sqfmi/beepy-hardware/3D/beepy-cases/slim_flat/README.md

# Slim, flat, minimal case for the Beepy
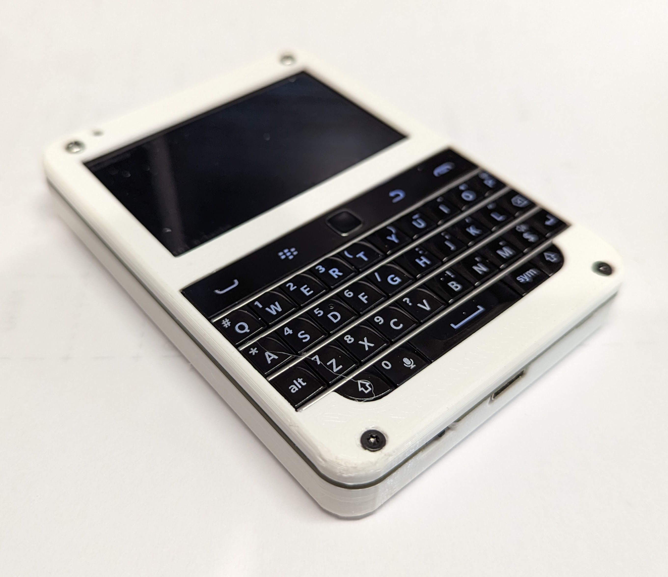
[picture p4: 3D/beepy-cases/slim_flat/images/01.jpg]
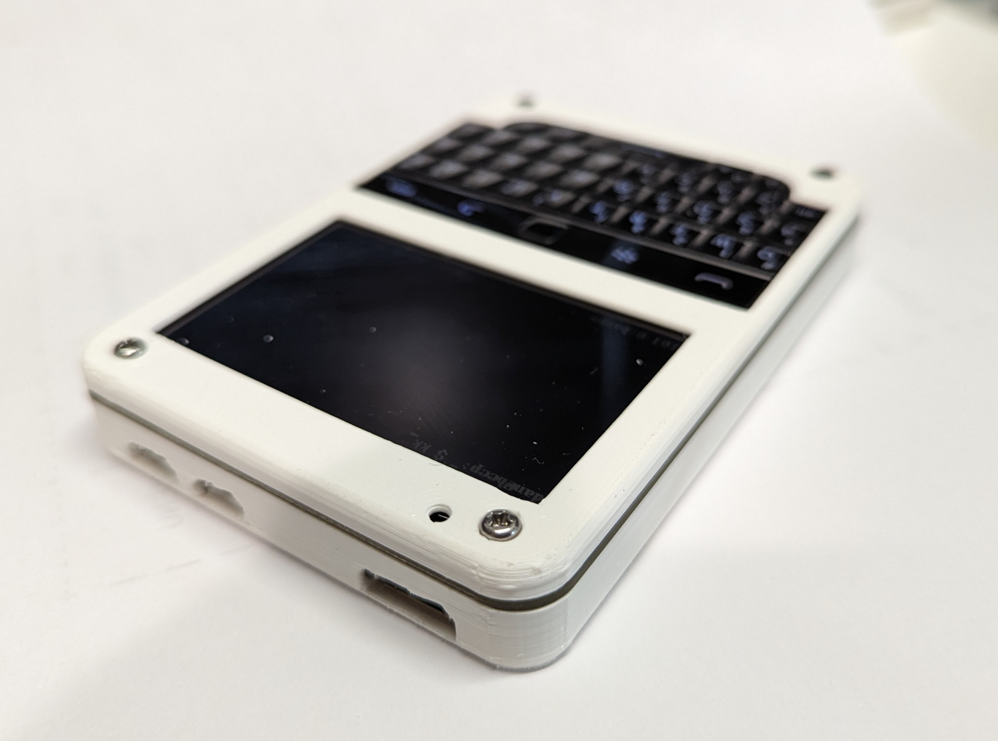
[picture p5: 3D/beepy-cases/slim_flat/images/02.jpg]
   
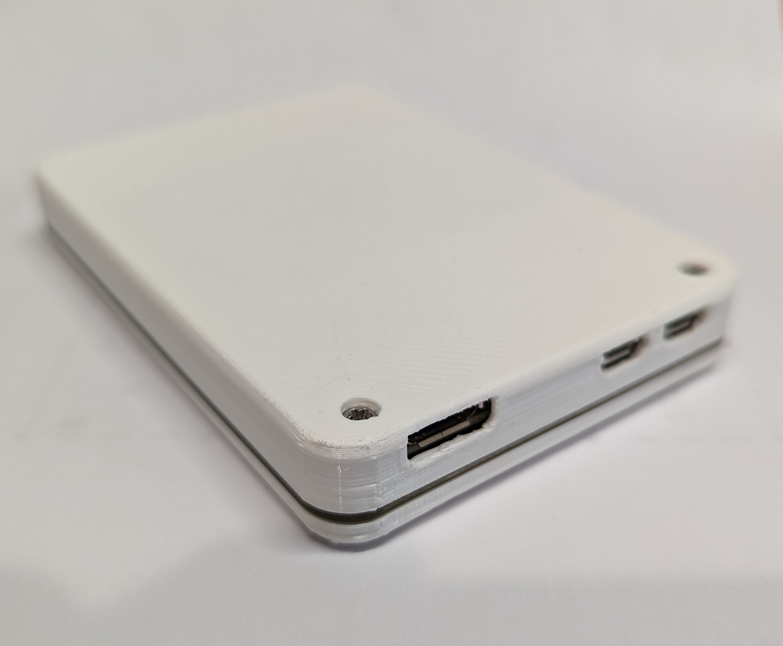
[picture p6: 3D/beepy-cases/slim_flat/images/03.jpg]
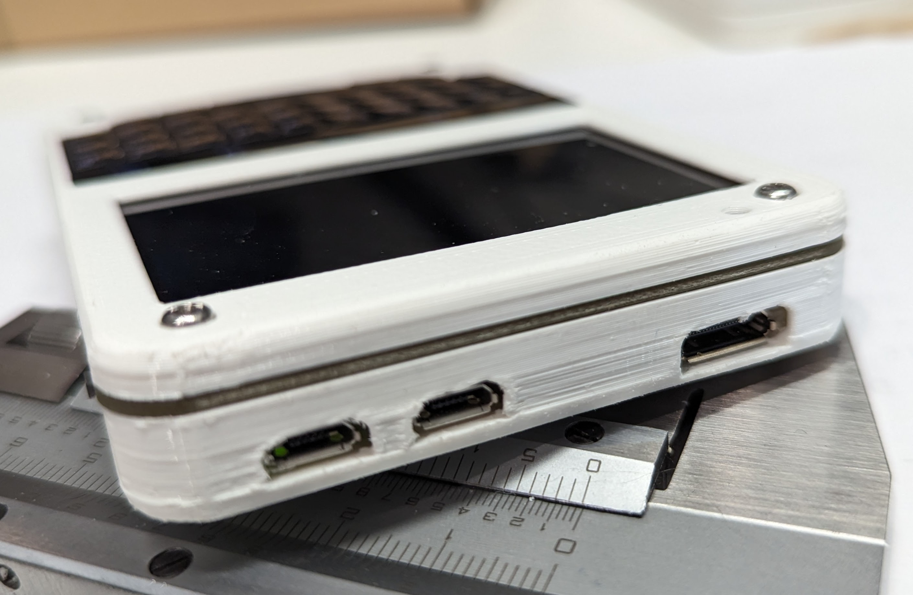
[picture p7: 3D/beepy-cases/slim_flat/images/04.jpg]
   
  
You can modify or export this design in different formats here: https://cad.onshape.com/documents/bd480b14f09d0e8bb1f02c35/w/8fd70d525d2eaf5fd9ab36e5/e/2a70bcd406a8aed3ac3e3c04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.  

**Changelog
* Rev 5 - initial release
* Rev 6 - added ribs to support the top screw holes of the back panel. Shold make them les likely to break.
  
**Parts List**
* Two printed parts
* Two 6mm plastic screws - I used these: https://www.amazon.com/gp/product/B00GDYNJNM.  Maybe you can find silber buttonhead that match the m2.5 screws.
* Four 6mm M2.5 scriws - I used the screws from this pack: https://www.amazon.com/gp/product/B01L06CUJG.
* A square of the packing foam from the Beepy box to cushion the battery, about the size of the battery

**Instructions**
* Print face down/back down. Supports are totally optional on the openings.  I had good luck with tree supports as they were easy to remove from delicate spots.
* Remove the top two screws from the pi.  Leave the screws holding it to the pogo pins.
* Put the foam between the battery and PCB, orient the battery so it doesn't cross its wire.
* Press the case together.  The foam should compress without much force.  Be careful not to damage the battery.
* Screw together.
* That's it!
  
Cut the foam around the big chips so airflow isn't blocked for them:  
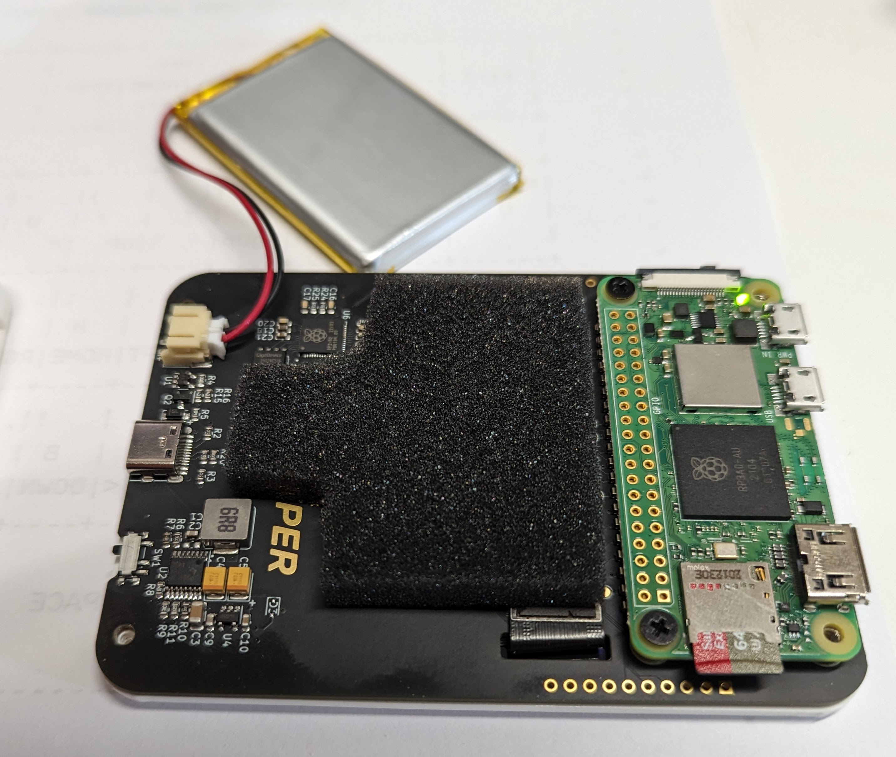
[picture p8: 3D/beepy-cases/slim_flat/images/06.jpg]
  
  
Battery on top:  
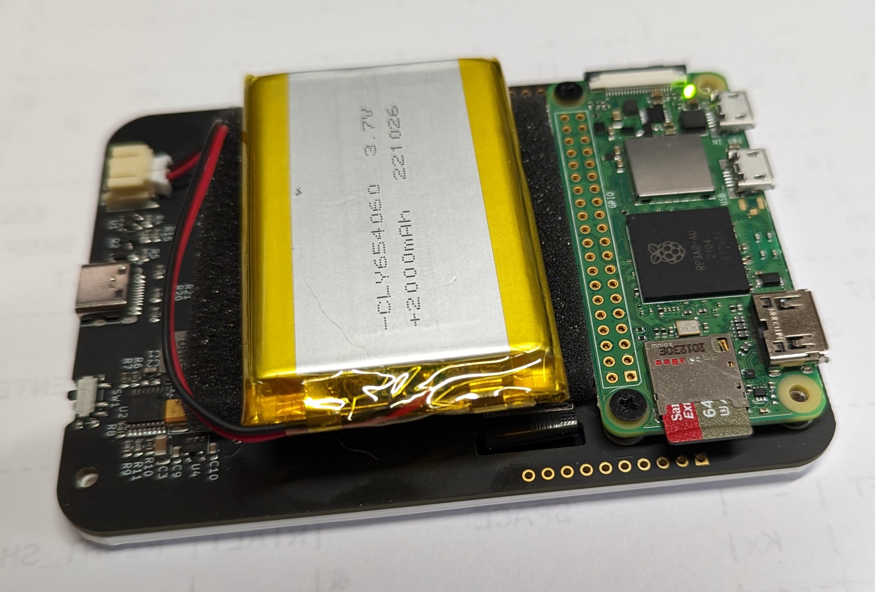
[picture p9: 3D/beepy-cases/slim_flat/images/07.jpg]
  

This end first:  
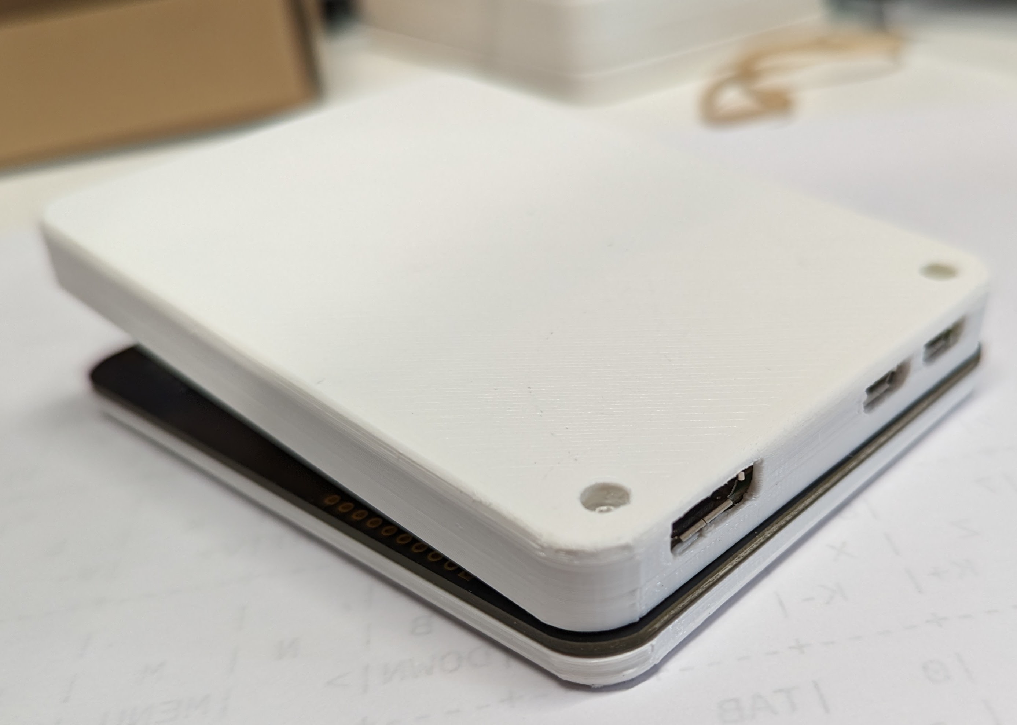
[picture p10: 3D/beepy-cases/slim_flat/images/05.jpg]
