sqfmi/beepy-hardware/3D/beepy-cases/slide/beepy-slide-v1.stl

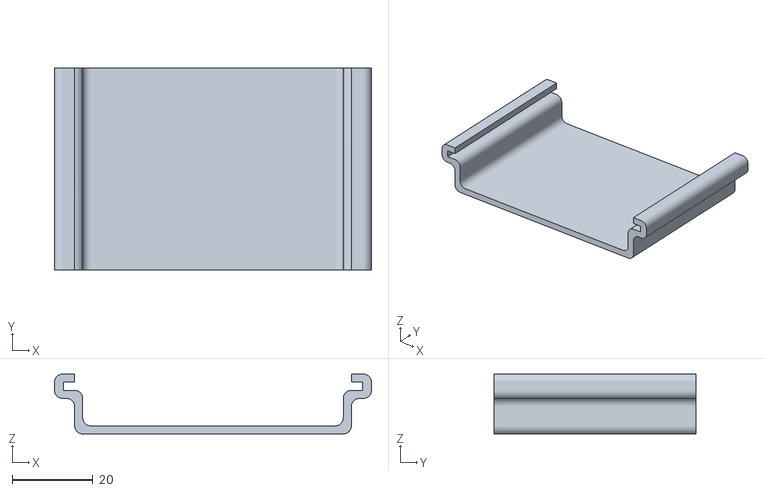
[picture p11: CAD file, 2023-08-16]
3D/beepy-cases/slide/beepy-slide-v1.stl
78.6 x 50.0 x 14.8
