sqfmi/beepy-hardware/3D/beepy-cases/slim_flat/Slim Case Rev6 - Back.step

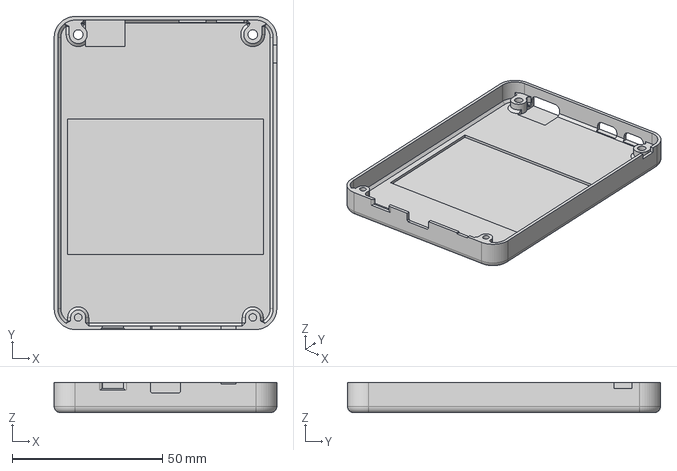
[picture p12: CAD file, 2023-06-11]
3D/beepy-cases/slim_flat/Slim Case Rev6 - Back.step
74.0 x 104.0 x 10.0 mm
