sqfmi/beepy-hardware/3D/beepy-cases/v1/beepy-case-v1.step

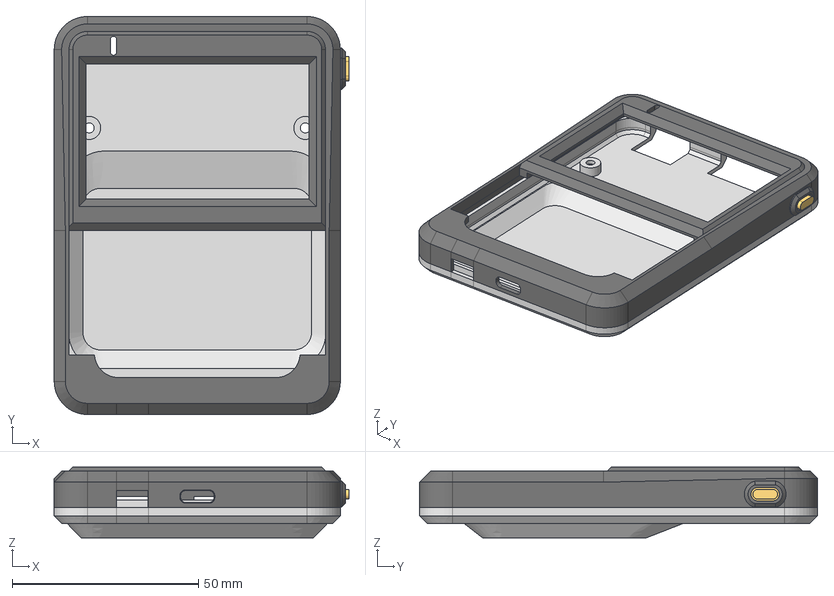
[picture p13: CAD file, 2023-08-16]
3D/beepy-cases/v1/beepy-case-v1.step
79.1 x 106.8 x 19.0 mm
