sqfmi/beepy-hardware/KiCad/keeb.step

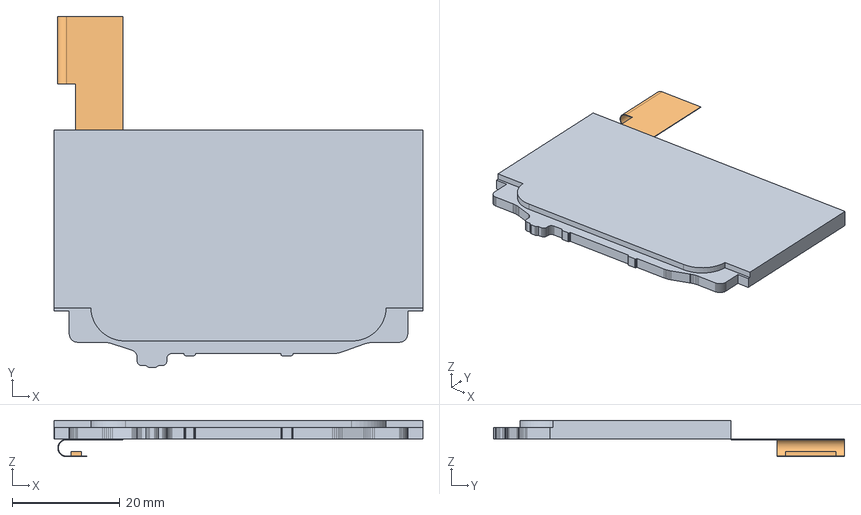
[picture p14: CAD file, 2023-09-08]
KiCad/keeb.step
68.3 x 65.1 x 6.76 mm
