sqfmi/beepy-hardware/3D/beepy-cases/v1/beepy-case-button.stl

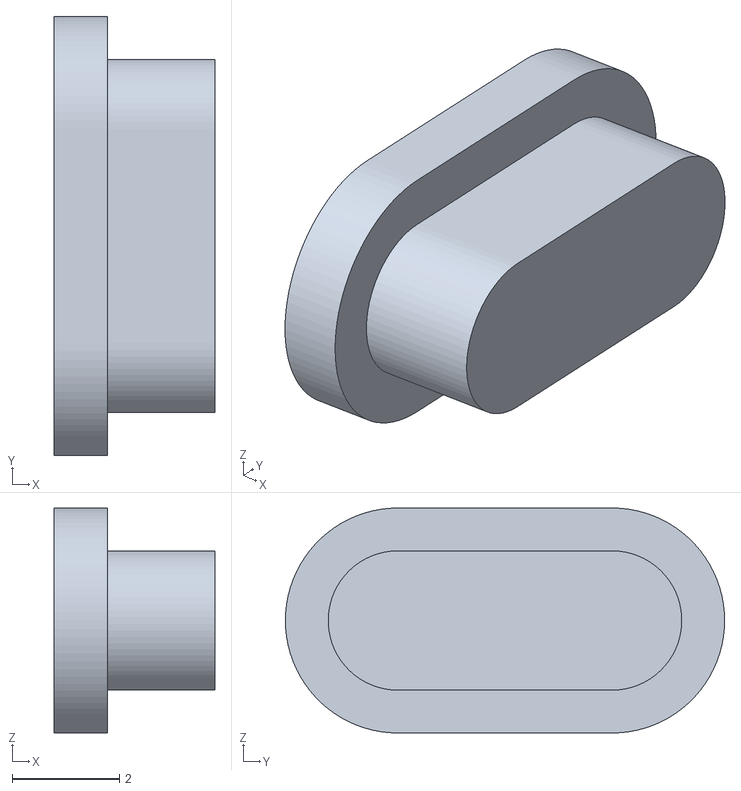
[picture p15: CAD file, 2023-06-08]
3D/beepy-cases/v1/beepy-case-button.stl
3.00 x 8.20 x 4.20
