sqfmi/beepy-hardware/3D/beepy-cases/slim_flat/Slim Case Rev5 - Front.step

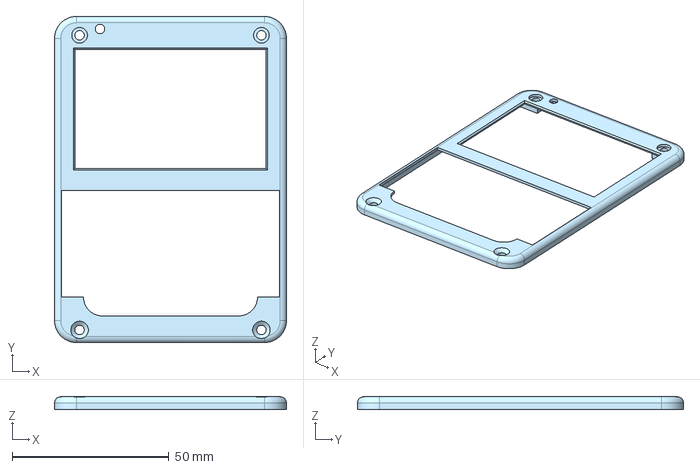
[picture p16: CAD file, 2023-06-09]
3D/beepy-cases/slim_flat/Slim Case Rev5 - Front.step
74.0 x 104.0 x 4.00 mm
