sqfmi/beepy-hardware/3D/beepy-cases/v1/beepy-case-back.stl

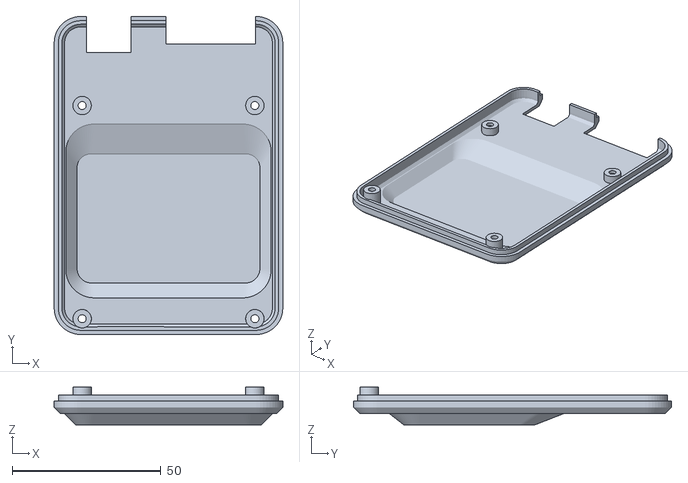
[picture p17: CAD file, 2023-06-08]
3D/beepy-cases/v1/beepy-case-back.stl
76.8 x 106.8 x 12.7
