sqfmi/beepy-hardware/3D/beepy-cases/v1/beepy-case-front.stl

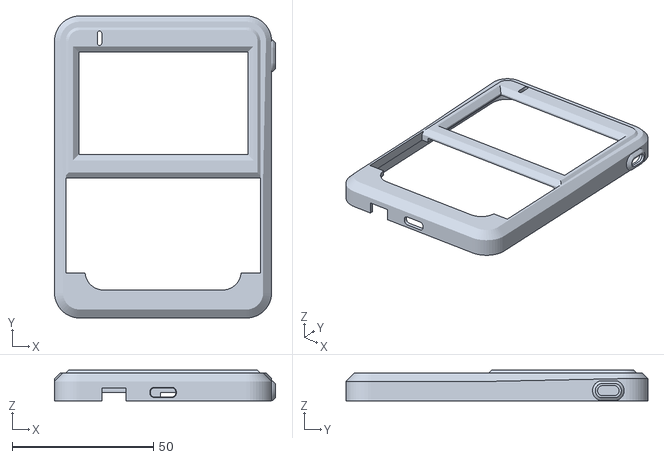
[picture p18: CAD file, 2023-06-08]
3D/beepy-cases/v1/beepy-case-front.stl
78.2 x 106.8 x 10.8
