sqfmi/beepy-hardware/(list of files, cad)

Other CAD files:
3D/beepy-cases/slim_flat/Slim Case Rev5 - Back.step
3D/beepy-cases/slim_flat/Slim Case Rev5 - Back.stl
3D/beepy-cases/slim_flat/Slim Case Rev5 - Front.stl
3D/beepy-cases/slim_flat/Slim Case Rev6 - Back.stl
