sqfmi/beepy-hardware/(threads)

Thread 3 (2023-06-02):

Create a enclosure case for TPU prints

57Bravo, 2023-06-02:
The current enclosure is awesome, but it would be nice to have a flexible case to put around it to protect from drops. Something that's flexible like TPU, similar to a phone case.

57Bravo, 2023-06-03:
Example:

[guard.webm](https://github.com/sqfmi/beepberry-hardware/assets/17078019/58eaa98f-83e3-4904-8abe-174c1a809653)

https://github.com/57Bravo/beepberry-hardware/blob/1-create-an-enclosure-case-for-tpu-prints/3D/beepberry-cases/v1/beepberry-case-guard.step

57Bravo, 2023-06-06:
Coarse prints:

[20230605_beeper_bumper.webm](https://github.com/sqfmi/beepberry-hardware/assets/17078019/180f68d4-6396-41d9-a3d5-4afc68dc6890)

Thread 5 (2023-06-03):

Publish 3D models for v1 enclosure in STEP or IGES format

57Bravo, 2023-06-03:
The v1 enclosure looks great. Can the models be published as STEP or IGES files as well? Although STL's can be manipulated in FreeCAD using mesh to object conversion, the result is typically harder to work with than a direct export to STEP/IGES.

sqfmi, 2023-06-08:
added :)

57Bravo, 2023-06-09:
Looks good, thanks.

Closed 2023-06-09.

Thread 6 (2023-06-09):

Consolidate expansion I/O into single stackable header in v2

57Bravo, 2023-06-09:
I like that you broke the extra I/O out for expansion. Mechanically though, I'd like to see it consolidated into single stack able header. I'd also switch from through hole to SMD like J45. You could probably route of all the expansion down just below the RPI header.

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

sockbot, 2023-06-10:
What about breaking out the gpio in the same layout as on the RPi itself? Then there would be compatibility with the entire ecosystem of HATs and accessories.

57Bravo, 2023-06-11:
Possibly. PCB real estate is pretty tight though. If you put another full 0.1" pitch header in there, that would be significant. Anything that stacks needs to fit in a 10mm ish depth, or the thing goes from handheld to laptop.

I do like common interfaces though. SFEs micromod / qwiic are some good examples.

Thread 7 (2023-06-09):

Flip the RPI in v2 and use ground plane to heat sink the CPU

57Bravo, 2023-06-09:
I'm a fan of filling with ground plane. In v2, I think you should fill both sides with ground plane. If you did that, you could flip the RPI over and heat sink it to the ground plane. If you stitch the edges with via, it will help transfer heat from one side to the other.

Flipped RPi with ground plane fill:

[untitled.webm](https://github.com/sqfmi/beepberry-hardware/assets/17078019/4c8a67b4-8909-4e32-8fea-eef9b2a588c7)

Ground plane stitching example:

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

sockbot, 2023-06-10:
Would flipping the orientation of the Pi prevent the use of the Pi camera due to the orientation of the camera cable?

Thread 8 (2023-06-09):

Create a LoRa transceiver add-on in v2

57Bravo, 2023-06-09:
I'm not sure how you'd package it, but it would be neat to integrate a LoRa transceiver in the next version of the board. You could use it to send and receive text like messages using LoRa gateways.

Use cases:
- Burst based text messaging
- One way broadcast paging
- SOS (that's a stretch without a GPS too, but maybe a coarse location could be calculated using multiple gateways w/o GPS.)

Aemilivs, 2023-06-09:
Imagine rendering global mobile communication infrastructure obsolete by introducing Lora circuit and application utilizing public keys for it in beepberry lmao

vitasam, 2023-06-09:
LoRa is a really good idea

57Bravo, 2023-06-09:
I'm thinking something like what they do with atak-civ.

https://meshtastic.org/docs/software/community/community-atak

I mean, no gui. Just the concept of the LoRa bridge for messaging.

vitasam, 2023-06-10:
Definitely no GUI!

And with mesh?

https://hackaday.com/2020/02/26/lora-mesh-network-with-off-the-shelf-hardware/

57Bravo, 2023-06-11:
Someone on the uConsole forums posted this. It's like beepberry with an mcu and onboard LoRa. https://www.lilygo.cc/products/t-deck

57Bravo, 2023-06-13:
Here's another LoRa/berry device.

https://hackaday.com/2022/05/25/long-distance-text-communication-with-lora/

https://github.com/BigCorvus/LORA-QWERTY-Communicator

Thread 11 (2023-06-10):

Add prototyping area to PCB

sockbot, 2023-06-10:
A prototyping area added to any blank space on the PCB would be useful to add through hole or smd ICs and other components without requiring external mounting.

Something like this:

https://learn.adafruit.com/adafruit-proto-shield-arduino/overview

Thread 12 (2023-06-13):

Expansion I/O mechanically interferes with SDCARD/MIPI jacks

57Bravo, 2023-06-13:
I want to make a shield like PCB for the side expansion I/O. Unfortunately the pins would interfere with the SDCARD/MIPI jacks.

I don't care so much about the MIPI jack, but I imagine I'll be inserting/removing the SDCARD a bunch. Unfortunately the 3 pins that interfere on the SD side are I2C. I'd like to use those guys for sensor integration.

**In V2 (if you keep the 0.1" I/O), slide the headers down a little so this interference is avoided.**

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

57Bravo, 2023-06-13:
This is what I want to do with the expansion:

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

Or maybe

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

57Bravo, 2023-07-10:
Here's what I ended up with mechanically to work around this:

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

57Bravo, 2023-07-27:
Here's the populated board running on the beepberry.

IMU, BARO, MAG, GPS, buzzer

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

Thread 13 (2023-06-16):

Create a CM4 carrier for V2

57Bravo, 2023-06-16:
It would be awesome if you could choose to use either rpi zerow or a CM4 module. Maybe you could make a conversion carrier? The volume seems to jive. I guess heat might be an issue though.

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

57Bravo, 2023-06-16:
Hummm... I didn't realize that the rpi zero 2W was a quad core. I just read that here:

https://beepberry.sqfmi.com/docs/software/os-image

```
Pi Zero 2W Settings

Restrict number of cores to limit peak power use - the Zero 2W can be limited to use
two cores and is still much faster than the pi zero, but peak power use is nearly
half of what 4 cores will use.

    sudo vi /boot/cmdline.txt
    Add "maxcpus=2" after "console=tty1".
    Reboot
```

Maybe the CM4 doesn't bring much to the table aside from more RAM and EMMC.

Thread 15 (2023-06-29):

Misc hardware notes

jamesmunns, 2023-06-29:
Here's a list of things that I've found while doing (a little bit weird) bringup for supporting my [mnemos](https://github.com/tosc-rs/mnemos) project.

* [ ] The display VCOM toggle pin is connected to the Pi Zero, not the RP2040. This means that the RP2040 cannot persist the image on the display while the Pi is off. Being able to drive the display AND the VCOM would be good, but at least with just VCOM, the RP2040 could persist the last drawn image from the Pi during deep sleep. [Sharp's documentation](https://www.sharpsde.com/fileadmin/products/Displays/2016_SDE_App_Note_for_Memory_LCD_programming_V1.3.pdf), the "VCOM" section discusses this
* [ ] There appears to be parasitic draw to the Pi Zero even when Q1 "Pi Power" mosfet is disabled. I believe this is caused by the 2x4.7k and 1x10k 3v3 pull-ups on the i2c bus. This could cause a few mA of draw, and probably isn't *great* for the attached hardware to be idling at a few volts (1.7v seen on the 5v0 rail on an MQ-Pro). This could be fixed by adding another mosfet between the 3v3 rail and the pullup resistors, so this could be cut with the same signal as is used for Q1 today.
* [ ] The FDX0019B1 "pogo" pins are not compatible with some boards, such as the MQ-Pro. I needed to design an adapter board to handle this. I could not find a datasheet for these, but it *seems* that 1.0mm PTH diameter works well (and the MQ-Pro must be smaller than this). It would be nice to use "real" spring loaded pogo pins in the future, for better compatibility.

jamesmunns, 2023-06-29:
The first item is *somewhat* important to address:

> When designing with a memory LCD panel, a decision must be made as to how VCOM will be generated. VCOM is an alternating signal that prevents a DC bias from being built up within the panel. If this DC bias is allowed to accumulate, it will eventually reach the point where the state of the liquid crystals in the panel cells cannot be changed by the panel electronics and the cells will no longer change state.

They aren't super clear if this is a "physically damages the panel" or "needs a power reset to clear the stuck pixels"

markatlnk, 2023-06-29:
The Raspberry Pi Raspian OS supports a real time clock. The DS1307 is cheap, I would put in a separate 3.3V regulator for it directly off the battery. Power consumption would be really low. Even if you decide not to populate it, it should work fine off the I2C buss. It would need a 32,768 crystal and a couple of caps.  Next spin of the board could put the pads on there at no extra cost and let people populate it if they wanted to.

Thread 17 (2023-07-14):

V1 Case needs a power slide button

57Bravo, 2023-07-14:
When doing development on the keyboard, I'm constantly sliding the power button on / off with the V1 case. I have to use a small screwdriver because the switch is tiny.

It would be nice it the V1 case had a small slide button so you could use your finger instead.

57Bravo, 2023-10-02:
FW updates now allow upper right button to gracefully power and shutdown rpi without sliding switch.

prokrypt, 2023-10-02:
I use the corner of a usb-c plug to toggle the switch.

57Bravo, 2023-10-02:
If you update the keyboard firmware and associated kernel module, the upper right hand button allows for digital power up/down. They also exposed the led to sysfs, so you can control it without unloading the keyboard kernel module to hit I2C directly.

prokrypt, 2023-10-02:
My switch does soft shutdown too, somehow...
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

57Bravo, 2023-10-02:
Mod city ha. Here's mine https://github.com/57Bravo/BeepSensors

Closed 2023-10-02.

Thread 18 (2023-07-14):

Add a clear qwerty key mapping to docs

57Bravo, 2023-07-14:
The qwerty keyboard doesn't clearly show alternate symbols like: [,],<,>,|, tab, pg up/down etc. It also doesn't show common modifiers like ctrl-c.

Add some documentation that talks about the key map for the default firmware.

It took me a couple of hours of fiddling to figure out the map so I could use tmux on the device.

57Bravo, 2023-07-18:
# bbqX0kbd_driver/source/mod_src/bbq20kbd_pmod_codes.h

```
/*
 *                                      BBQ20KBD PMOD KEYBOARD LAYOUT
 *
 *      +------+-----+----+----+----+----+----+-----+-----+-------+
 *      |      |          |BR     ↑TPY-       |           |       |
 *      | Ctrl |   PgDn   |←TPX- BL(HOME)TPX+→|   PgUp    | MENU  |
 *      |      |          |       ↓TPY+       |           |       |
 *      +------+-----+----+----+----+----+----+-----+-----+-------+
 *      |                                                         |
 *      +------+-----+----+----+----+----+----+-----+-----+-------+
 *      |#     |1    |2   |3   |(   |   )|_   |    -|    +|      @|
 *      |  Q   |  W  | E  | R  | T  |  Y |  U |  I  |  O  |   P   |
 *      |      |     |PgDn|PgUp|   \|UP  |^   |=    |{    |}      |
 *      +------+-----+----+----+----+----+----+-----+-----+-------+
 *      |*     |4    |5   |6   |/   |   :|;   |    '|    "|    ESC|
 *      |  A   |  S  | D  | F  | G  |  H |  J |  K  |  L  |  BKSP |
 *      |     ?|     |   [|   ]|LEFT|HOME|RGHT|V+   |V-   |DLT    |
 *      +------+-----+----+----+----+----+----+-----+-----+-------+
 *      |      |7    |8   |9   |?   |   !|,   |    .|    `|       |
 *      |LFTALT|  Z  | X  | C  | V  |  B |  N |  M  |  $  | ENTER |
 *      |      |   K+|  K-|   °|   <|DOWN|>   |MENU |Vx   |       |
 *      +------+-----+----+----+----+----+----+-----+-----+-------+
 *      |            |0   |TAB                |     |             |
 *      | LEFT_SHIFT | ~  |       SPACE       |RTALT| RIGHT_SHIFT |
 *      |            |  Kx|                  &|     |             |
 *      +------------+----+-------------------+-----+-------------+
 *
 * Notes:
 * Most Important to know:
 * To present a character as mentioned above a key in the above layout, use LFTALT + Key.
 * To present a character as mentioned below a key in the above layout, use RTALT + Key.
 *
 * Changes from arturo182's layout, if you are used to that, it's good to know these changes.
 * 1. Sym Key (Scancode 0x1D) on Keyboard is mapped to RTALT.
 * 3. The external buttons on the Keyboard Featherwing have been changed as below:
 *__3.1 Leftmost Button changed from Menu Key to Left Ctrl Key.
 *__3.2 Innet Left Button changed from Left Ctrl Key to Page Up Key.
 *__3.3 Inner Right Button changed from Back Key to Page Down Key.
 *__3.4 Outer Right Button changed from Left Shift Key to Menu Key.
 *__3.5 Center Key of 5-way Button changed from Enter Key to Home Key.
 */

```

sqfmi, 2023-09-08:
Docs updated with latest PR: https://beepy.sqfmi.com/docs/firmware/keyboard#symbol-key-map

57Bravo, 2023-09-08:
Thanks

Closed 2023-09-08.

Thread 19 (2023-08-05):

Add a piezo element for audio in Rev A HW

57Bravo, 2023-08-05:
I was able to use a piezo element to get my beepberry to speak using espeak. It would be nice if the next rev of HW had a buzzer/piezo for indications and audio.

A little tinny, but it's usable.

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

https://github.com/sqfmi/beepy-hardware/assets/17078019/80972862-f4a9-4f71-973d-3ff777216369

sockbot, 2023-08-05:
Could you upload a schematic and a BOM to this request so that I could look into reproducing it? Pictures of hardware install would be great too.

57Bravo, 2023-08-06:
Sure thing. I pushed the repo here.

https://github.com/57Bravo/BeepSensors

Thread 20 (2023-08-08):

Slim case — Lower front two screw holes do not fit the screw part suggested

jogloran, 2023-08-08:
Having printed the two halves of the slim case, the exact Amazon Torx-head screw part suggested by the README seem to spin freely in the bottom half of the case.

Is there any way we can get access to CAD files so that we can adjust the screw diameter of the holes?

jogloran, 2023-08-10:
I'm closing this as I just noticed the .step files in there.

a8ksh4, 2023-08-10:
There's a link to the cad model in Onshap in the readme, too.

jogloran, 2023-08-10:
Thanks. I shrank the hole -- works like a charm now.

Closed 2023-08-10.

Thread 22 (2023-08-22):

The slim case's thickness is too thin

dishangti, 2023-08-22:
When I print the case of nylon, it breaks. The producer suggests 2mm for the case of nylon, and 1.5mm for PLA and resin.
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
