sqfmi/beepy-hardware/KiCad/beepy-schematic-v1.pdf

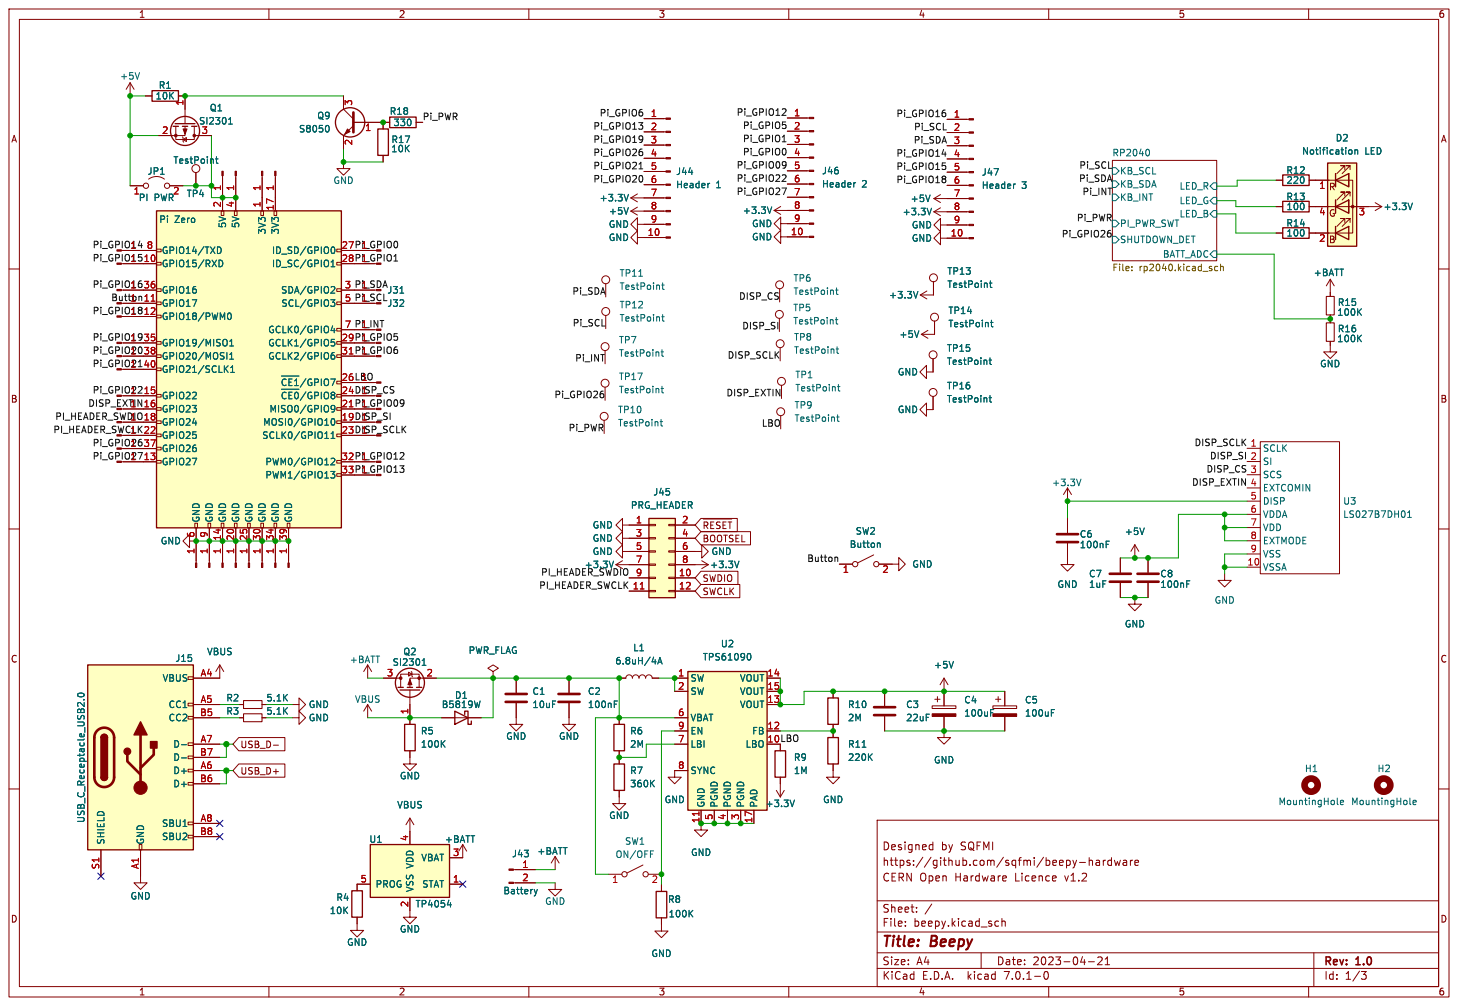
[picture p19: page 1]

1 TP5 TestPoint TP8 TestPoint TP9 TestPoint TP1 TestPoint GND GNDGND A1 VBUS A4 CC1 A5 D+ A6 D- A7 SBU1 A8 CC2 B5 D+ B6 D- B7 SBU2 B8 SHIELD S1

TP16 TestPoint TP15 TestPoint TP13 TestPoint TP14 TestPoint +3.3V

TP14 TestPoint TP13 TestPoint TP15 TestPoint TP16 TestPoint GND

LBI 7 SYNC 8 EN 9 GND

https://github.com/sqfmi/beepy-hardware

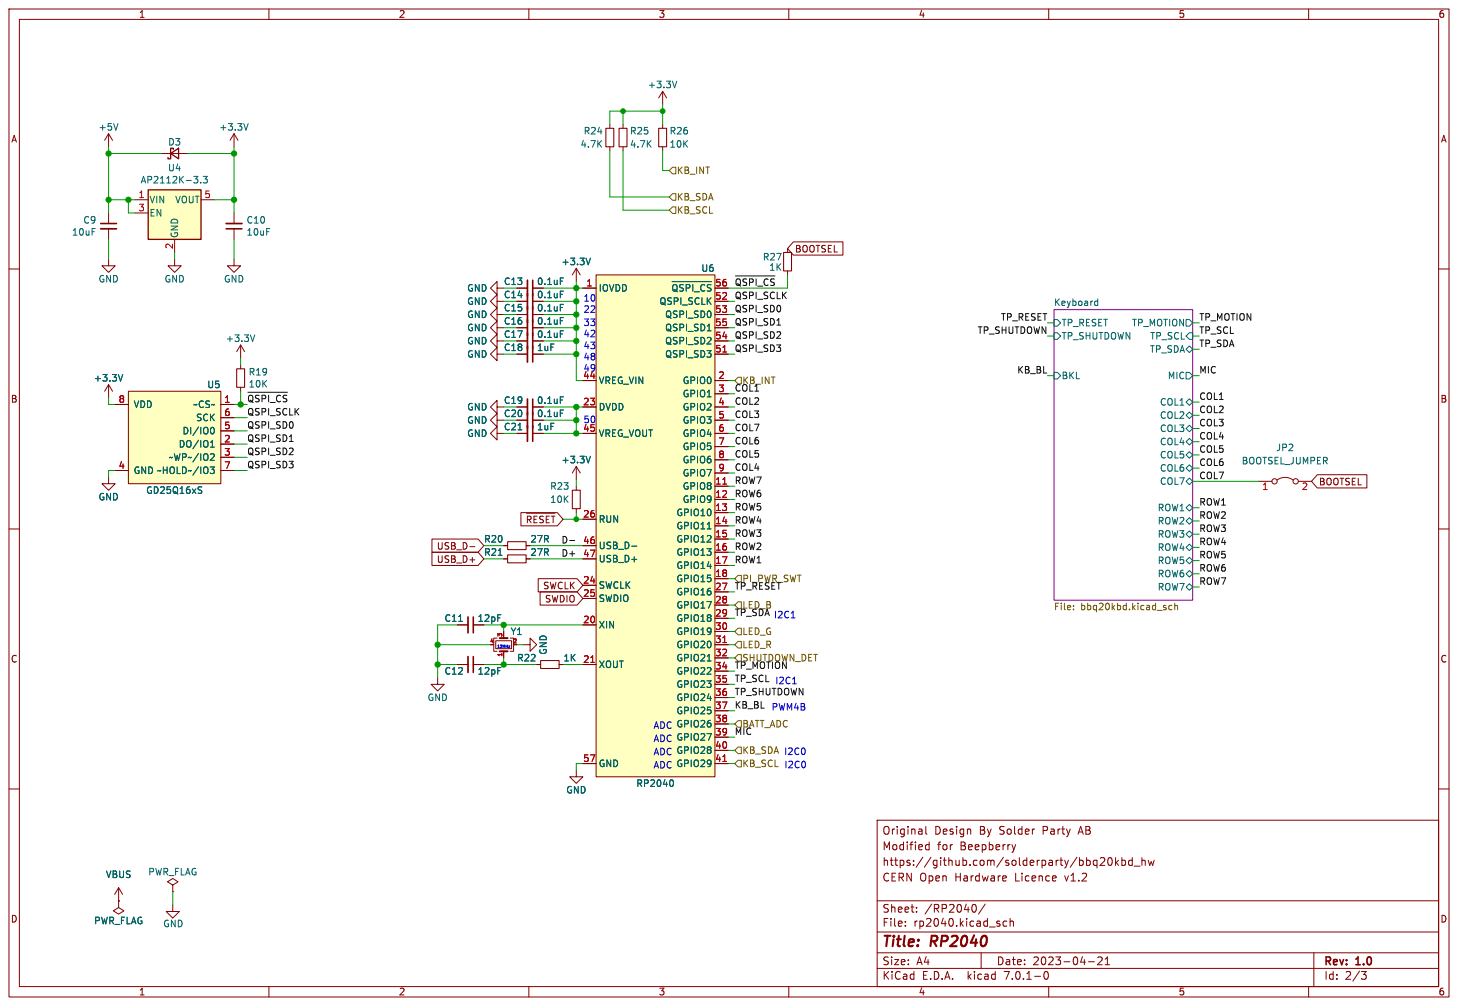
[picture p20: page 2]

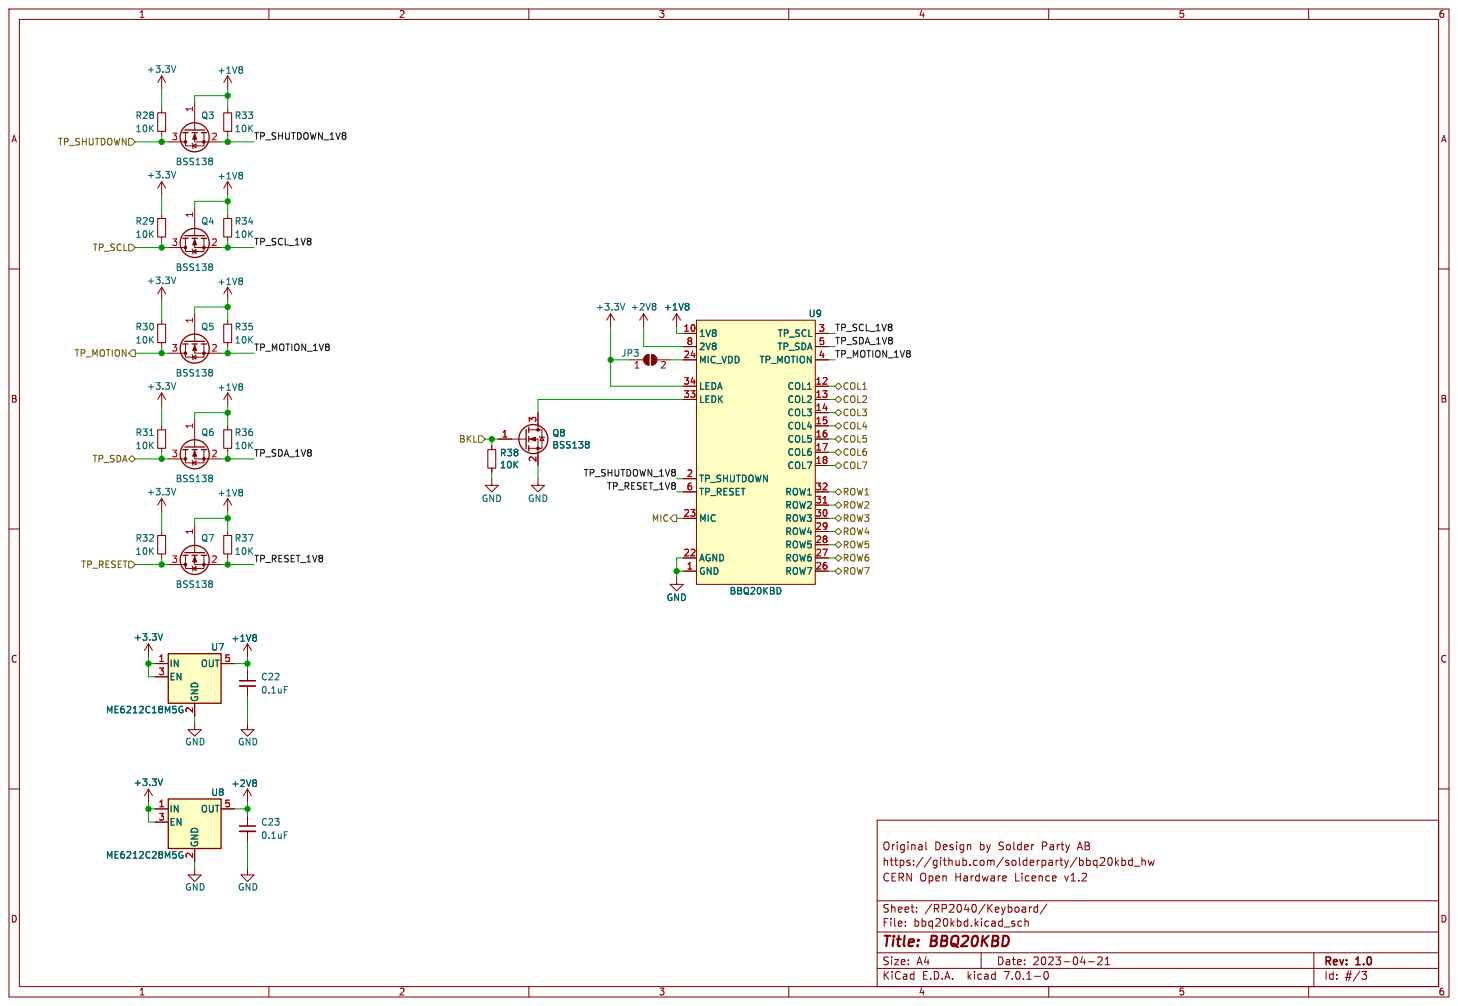
[picture p21: page 3]

https://github.com/solderparty/bbq20kbd_hw
