sqfmi/beepy-hardware/(commit log)

2023-06-08 adding KiCad files
    [bbq20kbd.kicad_sch, beepberry-case-back.stl, beepberry-case-button.stl, beepberry-case-front.stl, beepberry.kicad_pcb, beepberry.kicad_sch, keeb.step, rp2040.kicad_sch]
2023-06-08 add v1 case step
    [beepberry-case-v1.step]
2023-06-09 adding models and images
    [Slim Case Rev5 - Back.stl, Slim Case Rev5 - Front.stl]
2023-06-09 Add cad link
2023-06-09 Add step files
    [Slim Case Rev5 - Back.step, Slim Case Rev5 - Front.step]
2023-06-10 added rev6 models
    [Slim Case Rev6 - Back.step, Slim Case Rev6 - Back.stl]
2023-08-14 feat: add slide cover stl with readme
    [beepberry-slide-v1.stl]
2023-08-16 update files
    [Slim Case Rev5 - Back.step, Slim Case Rev5 - Back.stl, Slim Case Rev5 - Front.step, Slim Case Rev5 - Front.stl, Slim Case Rev6 - Back.step, Slim Case Rev6 - Back.stl, beepberry-case-back.stl, beepberry-case-button.stl]
